Clignoduino/PROJET-ARDUINO-CLIGNODUINO/README.md

# PROJET-ARDUINO-CLIGNODUINO 

Projet

Présentation du projet Clignoduino, un projet de programmation électronique. Son objectif est d’accroître la sécurité des cyclistes avec un gant capteur de mouvements et des leds. Le tout est connecté via Bluetooth.
------------------------------------------------------------------------------------------------------------------------------------------------
Presentation of the Clignoduino project, an electronic programming project. Its goal is to increase the safety of cyclists with a motion sensor glove and Leds. Everything is connected via Bluetooth.

# >[Lien vidéo projet Clignoduino](https://youtu.be/3Vm6xSf7FyY)
