Clignoduino/PROJET-ARDUINO-CLIGNODUINO/Rapports séances/Rapports séances.md

# Rapports de séances
Ce dossier comporte nos rapports de séances respectifs présentant le travail réalisé en cours.

This file contains our respective session reports outlining the work done in class.
