Clignoduino/PROJET-ARDUINO-CLIGNODUINO/cahierdescharges.pdf

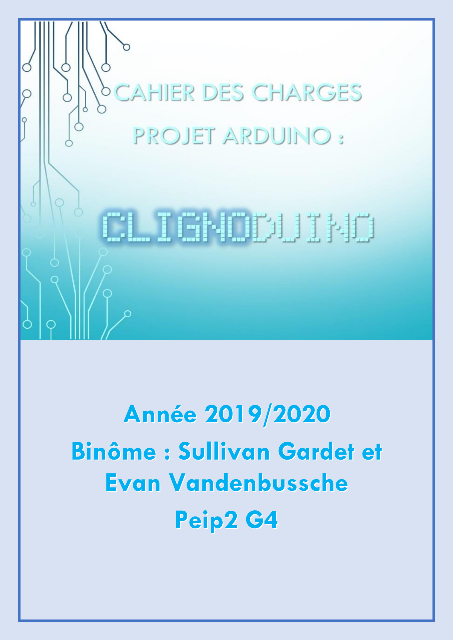
[picture p41: page 1]

Année 2019/2020
Binôme : Sullivan Gardet et Evan Vandenbussche
Peip2 G4

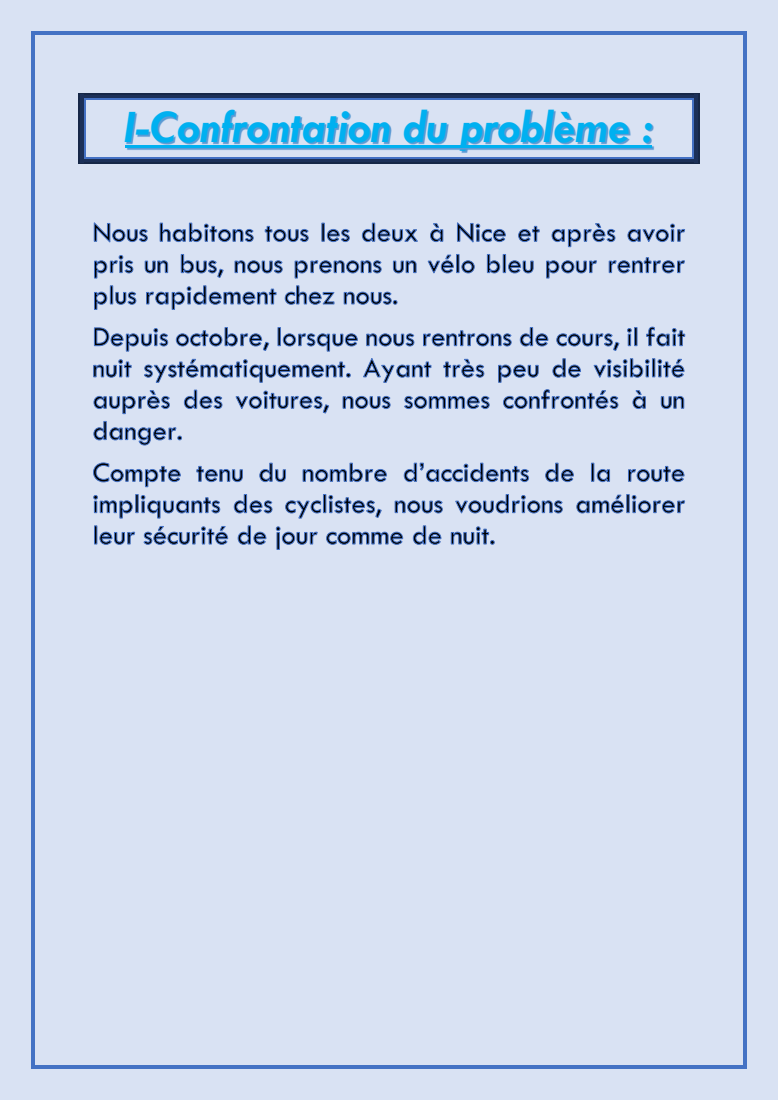
[picture p42: page 2]

I-Confrontation du problème :

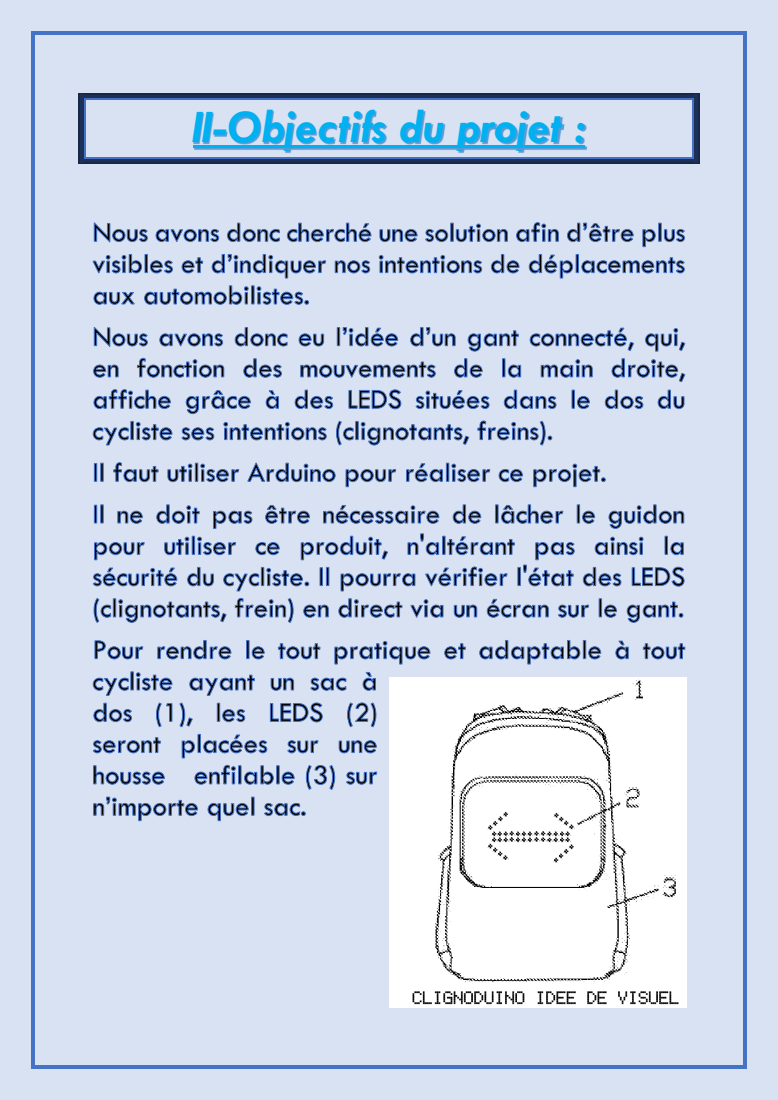
[picture p43: page 3]

II-Objectifs du projet :

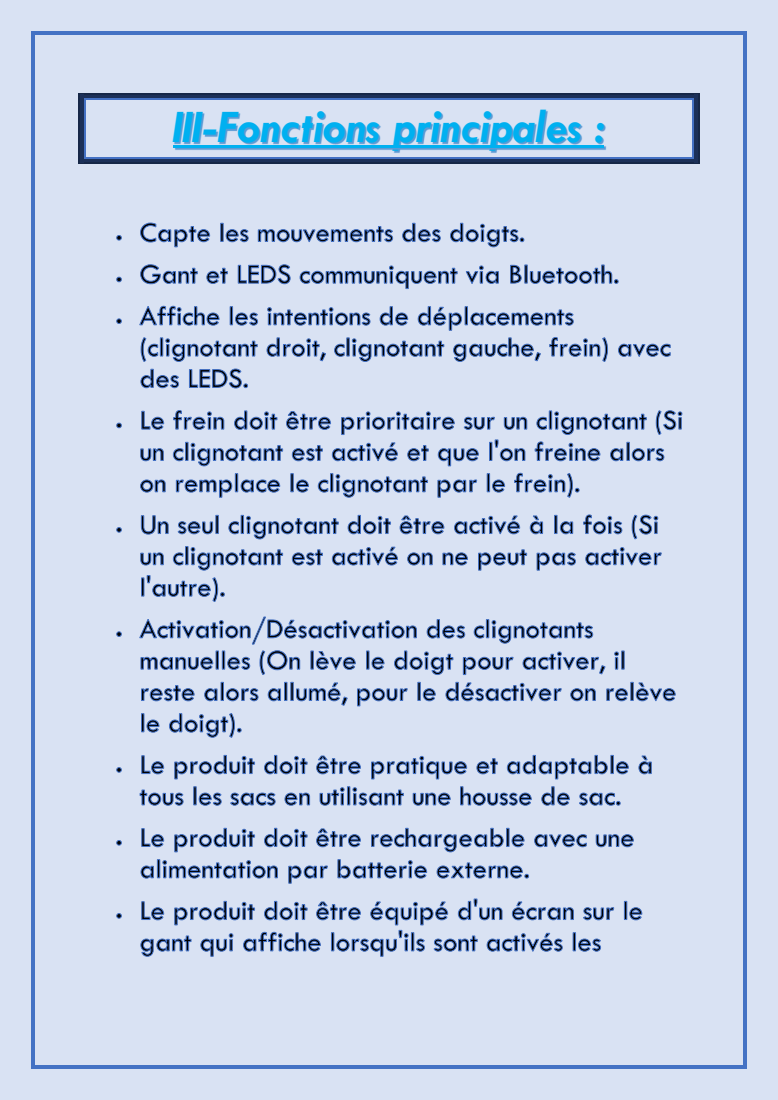
[picture p44: page 4]

III-Fonctions principales :

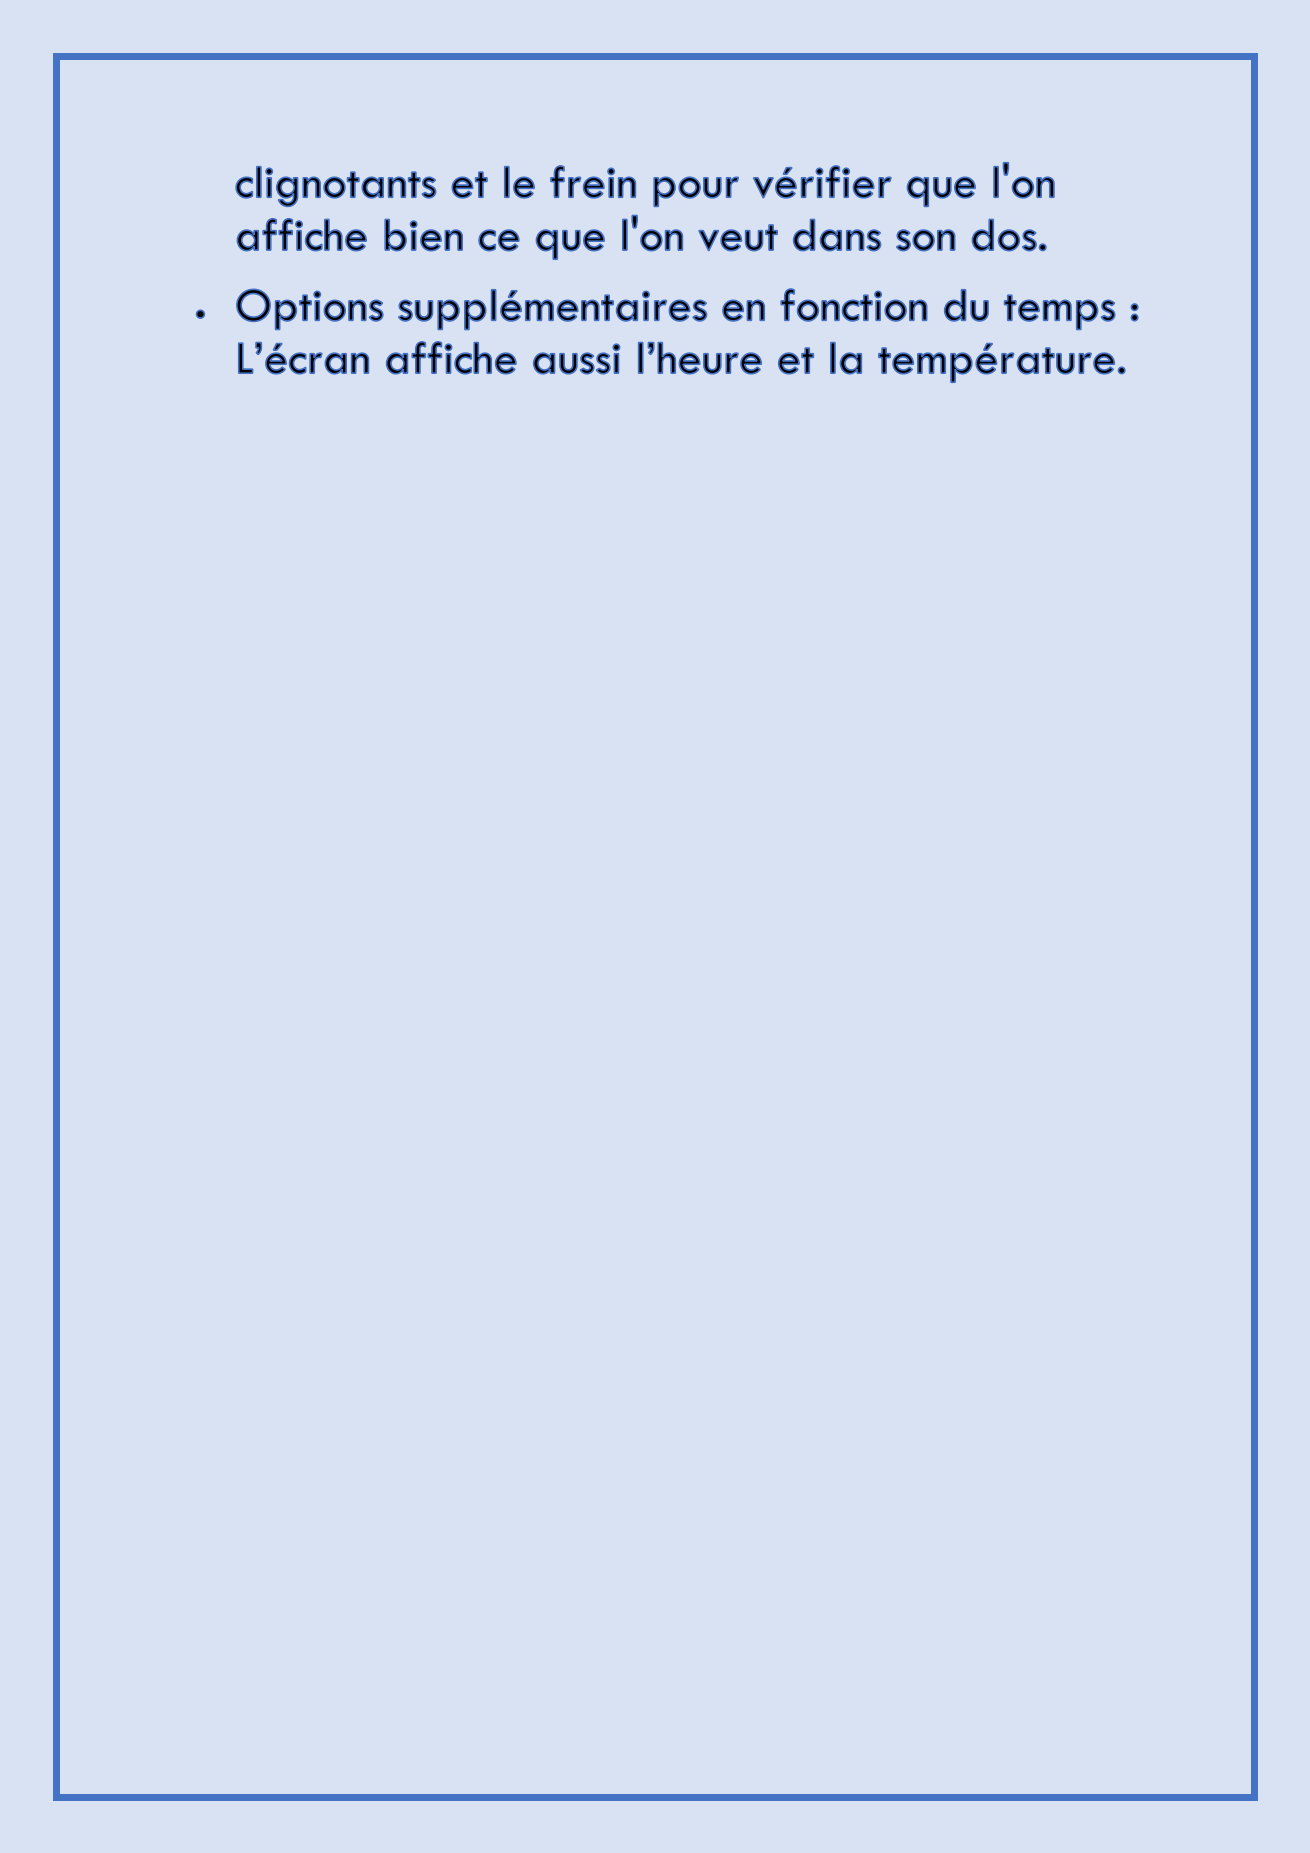
[picture p45: page 5]

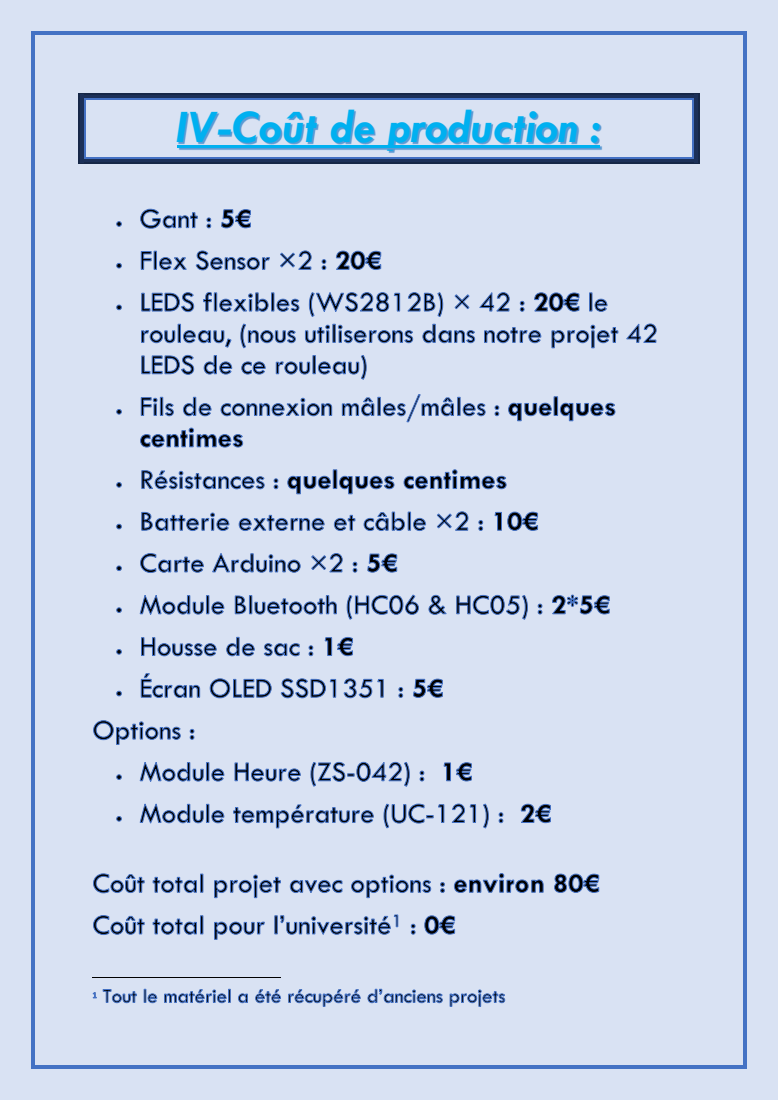
[picture p46: page 6]

IV-Coût de production :

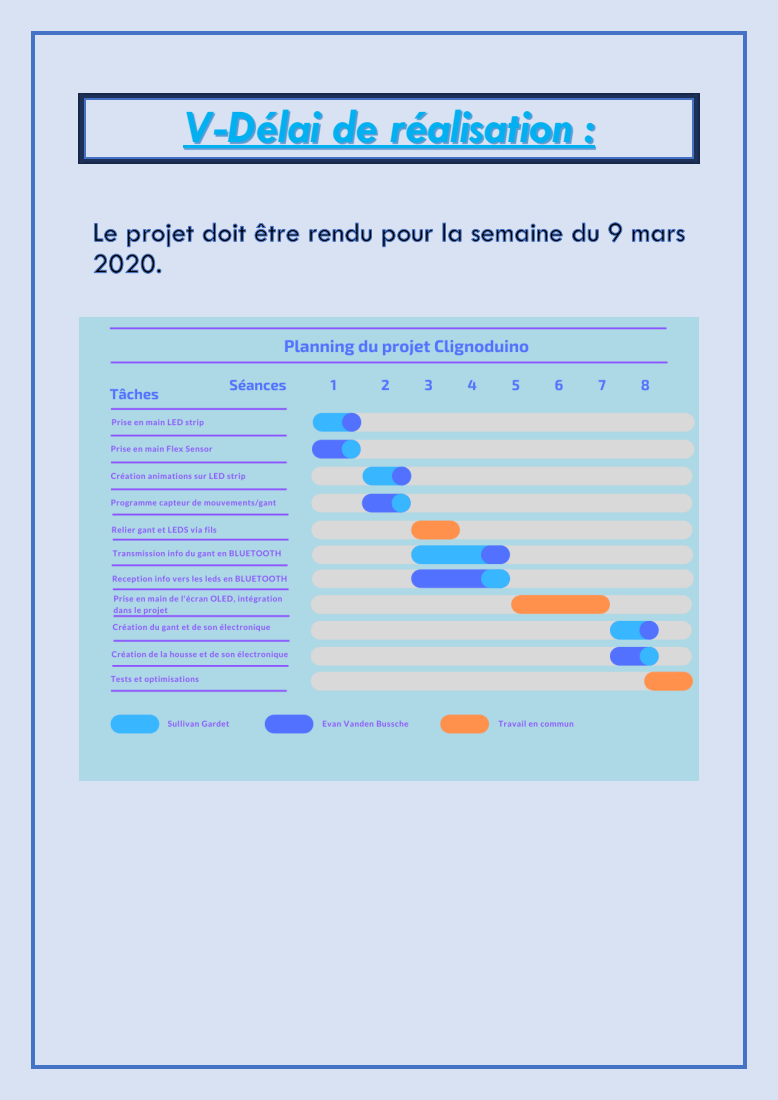
[picture p47: page 7]

V-Délai de réalisation :
