Clignoduino/PROJET-ARDUINO-CLIGNODUINO/Rapports séances/Séance 5/affichageimageecran.ino

#include <Wire.h>
#include <Adafruit_GFX.h>
#include <Adafruit_SH1106.h>

/* Puisque la bibliothèque est basée sur celle du SSD1306, le constructeur
prévoit qu'on passe le numéro de la broche RESET en argument. Mais le SH1106
n'a pas de broche RESET, alors on écrit n'importe quel entier (de préférence,
le numéro d'une broche de l'Arduino que vous n'utilisez pas). */

Adafruit_SH1106 display(23); 

const unsigned char flechedroite [] PROGMEM = {
0x00, 0x00, 0x00, 0x00, 0x00, 0x00, 0x00, 0x00, 0x00, 0x00, 0x00, 0x00, 0x00, 0x00, 0x00, 0x00, 
0x00, 0x00, 0x00, 0x00, 0x00, 0x00, 0x00, 0x00, 0x00, 0x00, 0x00, 0x00, 0x00, 0x00, 0x00, 0x00, 
0x00, 0x00, 0x00, 0x00, 0x00, 0x00, 0x00, 0x00, 0x00, 0x00, 0x00, 0x00, 0x00, 0x00, 0x00, 0x00, 
0x00, 0x00, 0x00, 0x00, 0x00, 0x00, 0x00, 0x00, 0x00, 0x00, 0x00, 0x00, 0x00, 0x00, 0x00, 0x00, 
0x00, 0x00, 0x00, 0x00, 0x00, 0x00, 0x00, 0x00, 0x00, 0x00, 0x00, 0x00, 0x00, 0x00, 0x00, 0x00, 
0x00, 0x00, 0x00, 0x00, 0x00, 0x00, 0x00, 0x00, 0x00, 0x00, 0x00, 0x00, 0x00, 0x00, 0x00, 0x00, 
0x00, 0x00, 0x00, 0x00, 0x00, 0x00, 0x00, 0x00, 0x00, 0x00, 0x00, 0x00, 0x00, 0x00, 0x00, 0x00, 
0x00, 0x00, 0x00, 0x00, 0x00, 0x03, 0xff, 0xff, 0xff, 0x00, 0x01, 0xff, 0xff, 0xff, 0x80, 0x00, 
0x1f, 0xff, 0xff, 0xfc, 0x00, 0x01, 0xff, 0xff, 0xff, 0x80, 0x00, 0xff, 0xff, 0xff, 0x80, 0x00, 
0x0f, 0xff, 0xff, 0xfc, 0x00, 0x01, 0xff, 0xff, 0xff, 0x80, 0x00, 0xff, 0xff, 0xff, 0xc0, 0x00, 
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
  
  display.display();
  delay(1000);
  display.clearDisplay();
  
  display.fillRect(0,0,128,64,WHITE);  // fond blanc derrière l'image bitmap
  display.drawBitmap(0, 0,frein, 128,  64, BLACK);
  
  display.display();
  delay(1000);
  display.clearDisplay();

}
