Clignoduino/PROJET-ARDUINO-CLIGNODUINO/Programmes/Gant/ecran.h

#include <Wire.h>
#include <Adafruit_GFX.h>
#include <Adafruit_SH1106.h>
/* Puisque la bibliothèque est basée sur celle du SSD1306, le constructeur
prévoit qu'on passe le numéro de la broche RESET en argument. Mais le SH1106
n'a pas de broche RESET, alors on écrit n'importe quel entier (de préférence,
le numéro d'une broche de l'Arduino que l'on utilise pas). */
Adafruit_SH1106 display(23); 

//Image fleche droite
const unsigned char flechedroite [] PROGMEM = {0x00, 0x00, 0x00, 0x00, 0x00, 0x00, 0x00, 0x00, 0x00, 0x00, 0x00, 0x00, 0x00, 0x00, 0x00, 0x00, 0x00, 0x00, 0x00, 0x00, 0x00, 0x00, 0x00, 0x00, 0x00, 0x00, 0x00, 0x00, 0x00, 0x00, 0x00, 0x00, 0x00, 0x00, 0x00, 0x00, 0x00, 0x00, 0x00, 0x00, 0x00, 0x00, 0x00, 0x00, 0x00, 0x00, 0x00, 0x00, 0x00, 0x00, 0x00, 0x00, 0x00, 0x00, 0x00, 0x00, 0x00, 0x00, 0x00, 0x00, 0x00, 0x00, 0x00, 0x00, 0x00, 0x00, 0x00, 0x00, 0x00, 0x00, 0x00, 0x00, 0x00, 0x00, 0x00, 0x00, 0x00, 0x00, 0x00, 0x00, 0x00, 0x00, 0x00, 0x00, 0x00, 0x00, 0x00, 0x00, 0x00, 0x00, 0x00, 0x00, 0x00, 0x00, 0x00, 0x00, 0x00, 0x00, 0x00, 0x00, 0x00, 0x00, 0x00, 0x00, 0x00, 0x00, 0x00, 0x00, 0x00, 0x00, 0x00, 0x00, 0x00, 0x00, 0x00, 0x00, 0x00, 0x03, 0xff, 0xff, 0xff, 0x00, 0x01, 0xff, 0xff, 0xff, 0x80, 0x00, 0x1f, 0xff, 0xff, 0xfc, 0x00, 0x01, 0xff, 0xff, 0xff, 0x80, 0x00, 0xff, 0xff, 0xff, 0x80, 0x00, 0x0f, 0xff, 0xff, 0xfc, 0x00, 0x01, 0xff, 0xff, 0xff, 0x80, 0x00, 0xff, 0xff, 0xff, 0xc0, 0x00, 0x0f, 0xff, 0xff, 0xfe, 0x00, 0x00, 0xff, 0xff, 0xff, 0xc0, 0x00, 0x7f, 0xff, 0xff, 0xc0, 0x00, 0x07, 0xff, 0xff, 0xff, 0x00, 0x00, 0xff, 0xff, 0xff, 0xc0, 0x00, 0x7f, 0xff, 0xff, 0xe0, 0x00, 0x03, 0xff, 0xff, 0xff, 0x00, 0x00, 0x7f, 0xff, 0xff, 0xe0, 0x00, 0x3f, 0xff, 0xff, 0xe0, 0x00, 0x03, 0xff, 0xff, 0xff, 0x80, 0x00, 0x3f, 0xff, 0xff, 0xf0, 0x00, 0x1f, 0xff, 0xff, 0xf0, 0x00, 0x01, 0xff, 0xff, 0xff, 0x80, 0x00, 0x3f, 0xff, 0xff, 0xf0, 0x00, 0x1f, 0xff, 0xff, 0xf0, 0x00, 0x01, 0xff, 0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
x00, 0x00, 0x00, 0x00, 0x00, 0x00, 0x00, 0x00, 0x00, 0x00, 0x00, 0x00, 0x00, 0x00, 0x00, 0x00, 0x00, 0x00, 0x00, 0x00, 0x00, 0x00, 0x00, 0x00, 0x00, 0x00, 0x00, 0x00, 0x00, 0x00, 0x00, 0x00};

//Image fleche gauche
const unsigned char flechegauche [] PROGMEM = {0x00, 0x00, 0x00, 0x00, 0x00, 0x00, 0x00, 0x00, 0x00, 0x00, 0x00, 0x00, 0x00, 0x00, 0x00, 0x00, 0x00, 0x00, 0x00, 0x00, 0x00, 0x00, 0x00, 0x00, 0x00, 0x00, 0x00, 0x00, 0x00, 0x00, 0x00, 0x00, 0x00, 0x00, 0x00, 0x00, 0x00, 0x00, 0x00, 0x00, 0x00, 0x00, 0x00, 0x00, 0x00, 0x00, 0x00, 0x00, 0x00, 0x00, 0x00, 0x00, 0x00, 0x00, 0x00, 0x00, 0x00, 0x00, 0x00, 0x00, 0x00, 0x00, 0x00, 0x00, 0x00, 0x00, 0x00, 0x00, 0x00, 0x00, 0x00, 0x00, 0x00, 0x00, 0x00, 0x00, 0x00, 0x00, 0x00, 0x00, 0x00, 0x00, 0x00, 0x00, 0x00, 0x00, 0x00, 0x00, 0x00, 0x00, 0x00, 0x00, 0x00, 0x00, 0x00, 0x00, 0x00, 0x00, 0x00, 0x00, 0x00, 0x00, 0x00, 0x00, 0x00, 0x00, 0x00, 0x00, 0x00, 0x00, 0x00, 0x00, 0x00, 0x01, 0xff, 0xff, 0xff, 0x80, 0x00, 0xff, 0xff, 0xff, 0xc0, 0x00, 0x00, 0x00, 0x00, 0x00, 0x00, 0x01, 0xff, 0xff, 0xff, 0x00, 0x01, 0xff, 0xff, 0xff, 0x80, 0x00, 0x3f, 0xff, 0xff, 0xf8, 0x00, 0x03, 0xff, 0xff, 0xff, 0x00, 0x01, 0xff, 0xff, 0xff, 0x80, 0x00, 0x3f, 0xff, 0xff, 0xf0, 0x00, 0x03, 0xff, 0xff, 0xfe, 0x00, 0x03, 0xff, 0xff, 0xff, 0x00, 0x00, 0x7f, 0xff, 0xff, 0xf0, 0x00, 0x07, 0xff, 0xff, 0xfe, 0x00, 0x03, 0xff, 0xff, 0xff, 0x00, 0x00, 0xff, 0xff, 0xff, 0xe0, 0x00, 0x07, 0xff, 0xff, 0xfc, 0x00, 0x07, 0xff, 0xff, 0xfe, 0x00, 0x00, 0xff, 0xff, 0xff, 0xc0, 0x00, 0x0f, 0xff, 0xff, 0xf8, 0x00, 0x07, 0xff, 0xff, 0xfc, 0x00, 0x01, 0xff, 0xff, 0xff, 0xc0, 0x00, 0x0f, 0xff, 0xff, 0xf8, 0x00, 0x0f, 0xff, 0xff, 0xfc, 0x00, 0x01, 0xff, 0xff, 0xff, 0x80, 0x00, 0x1f, 0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
00, 0x00, 0x00, 0x00, 0x00, 0x00, 0x00, 0x00, 0x00, 0x00, 0x00, 0x00, 0x00, 0x00, 0x00, 0x00, 0x00, 0x00, 0x00, 0x00, 0x00, 0x00, 0x00, 0x00, 0x00, 0x00, 0x00, 0x00, 0x00, 0x00, 0x00, 0x00};

//Animation Sablier
const unsigned char PROGMEM frame0 [] = {0x00, 0x00, 0x00, 0x00, 0x00, 0x00, 0x00, 0x00, 0x00, 0xFF, 0xFF, 0xFF, 0xFF, 0xFF, 0xFF, 0x00, 0x01, 0xFF, 0xFF, 0xFF, 0xFF, 0xFF, 0xFF, 0x80, 0x00, 0xFF, 0xFF, 0xFF, 0xFF, 0xFF, 0xFF, 0x00, 0x01, 0xC0, 0x00, 0x00, 0x00, 0x00, 0x03, 0x80, 0x00, 0xC0, 0x00, 0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
const unsigned char PROGMEM frame3 [] = {0x00, 0x00, 0x00, 0x00, 0x00, 0x00, 0x00, 0x00, 0x00, 0xFF, 0xFF, 0xFF, 0xFF, 0xFF, 0xFF, 0x00, 0x01, 0xFF, 0xFF, 0xFF, 0xFF, 0xFF, 0xFF, 0x80, 0x00, 0xFF, 0xFF, 0xFF, 0xFF, 0xFF, 0xFF, 0x00, 0x01, 0xC0, 0x00, 0x00, 0x00, 0x00, 0x03, 0x80, 0x00, 0xC0, 0x00, 0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
const unsigned char PROGMEM frame5 [] = {0x00, 0x00, 0x00, 0x00, 0x00, 0x00, 0x00, 0x00, 0x00, 0x00, 0x00, 0x00, 0x00, 0x00, 0x00, 0x00, 0x00, 0x00, 0x00, 0x00, 0x00, 0x00, 0x00, 0x00, 0x00, 0x00, 0x00, 0x07, 0x00, 0x00, 0x00, 0x00, 0x00, 0x00, 0x00, 0x0F, 0x80, 0x00, 0x00, 0x00, 0x00, 0x00, 0x00, 0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
const unsigned char PROGMEM frame6 [] = {0x00, 0x00, 0x00, 0x00, 0x00, 0x00, 0x00, 0x00, 0x00, 0x00, 0x00, 0x00, 0x00, 0x00, 0x00, 0x00, 0x00, 0x00, 0x00, 0x00, 0x00, 0x00, 0x00, 0x00, 0x00, 0x00, 0x00, 0x00, 0x00, 0x00, 0x00, 0x00, 0x00, 0x00, 0x00, 0x00, 0x00, 0x00, 0x00, 0x00, 0x00, 0x00, 0x00, 0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
const unsigned char PROGMEM frame8 [] = {0x00, 0x00, 0x00, 0x00, 0x00, 0x00, 0x00, 0x00, 0x00, 0x00, 0x00, 0x00, 0x00, 0x0F, 0x80, 0x00, 0x00, 0x00, 0x00, 0x00, 0x05, 0xFF, 0xC0, 0x00, 0x00, 0x00, 0x00, 0x00, 0xBF, 0xFF, 0xC0, 0x00, 0x00, 0x00, 0x00, 0x1F, 0xFF, 0xE1, 0xC0, 0x00, 0x00, 0x00, 0x0F, 0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
const unsigned char PROGMEM frame10 [] = {0x00, 0x00, 0x00, 0x00, 0x00, 0x00, 0x00, 0x00, 0x00, 0x3F, 0xF5, 0x00, 0x00, 0x00, 0x00, 0x00, 0x00, 0x3F, 0xFF, 0xFF, 0xFF, 0x54, 0x00, 0x00, 0x00, 0x3F, 0xFF, 0xFF, 0xFF, 0xFF, 0xFF, 0x00, 0x00, 0x38, 0x00, 0x57, 0xFF, 0xFF, 0xFF, 0x80, 0x00, 0x30, 0x00, 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
const unsigned char PROGMEM frame13 [] = {0x00, 0x00, 0x00, 0x00, 0x00, 0x00, 0x00, 0x00, 0x00, 0xFF, 0xFF, 0xFF, 0xFF, 0xFF, 0xFF, 0x00, 0x01, 0xFF, 0xFF, 0xFF, 0xFF, 0xFF, 0xFF, 0x80, 0x00, 0xFF, 0xFF, 0xFF, 0xFF, 0xFF, 0xFF, 0x00, 0x01, 0xC0, 0x00, 0x00, 0x00, 0x00, 0x03, 0x80, 0x00, 0xC0, 0x00, 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
const unsigned char PROGMEM frame15 [] = {0x00, 0x00, 0x00, 0x00, 0x00, 0x00, 0x00, 0x00, 0x00, 0xFF, 0xFF, 0xFF, 0xFF, 0xFF, 0xFF, 0x00, 0x01, 0xFF, 0xFF, 0xFF, 0xFF, 0xFF, 0xFF, 0x80, 0x00, 0xFF, 0xFF, 0xFF, 0xFF, 0xFF, 0xFF, 0x00, 0x01, 0xC0, 0x00, 0x00, 0x00, 0x00, 0x03, 0x80, 0x00, 0xC0, 0x00, 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
const unsigned char PROGMEM frame17 [] = {0x00, 0x00, 0x00, 0x00, 0x00, 0x00, 0x00, 0x00, 0x00, 0xFF, 0xFF, 0xFF, 0xFF, 0xFF, 0xFF, 0x00, 0x01, 0xFF, 0xFF, 0xFF, 0xFF, 0xFF, 0xFF, 0x80, 0x00, 0xFF, 0xFF, 0xFF, 0xFF, 0xFF, 0xFF, 0x00, 0x01, 0xC0, 0x00, 0x00, 0x00, 0x00, 0x03, 0x80, 0x00, 0xC0, 0x00, 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
const unsigned char PROGMEM frame19 [] = {0x00, 0x00, 0x00, 0x00, 0x00, 0x00, 0x00, 0x00, 0x00, 0xFF, 0xFF, 0xFF, 0xFF, 0xFF, 0xFF, 0x00, 0x01, 0xFF, 0xFF, 0xFF, 0xFF, 0xFF, 0xFF, 0x80, 0x00, 0xFF, 0xFF, 0xFF, 0xFF, 0xFF, 0xFF, 0x00, 0x01, 0xC0, 0x00, 0x00, 0x00, 0x00, 0x03, 0x80, 0x00, 0xC0, 0x00, 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
const unsigned char PROGMEM frame21 [] = {0x00, 0x00, 0x00, 0x00, 0x00, 0x00, 0x00, 0x00, 0x00, 0xFF, 0xFF, 0xFF, 0xFF, 0xFF, 0xFF, 0x00, 0x01, 0xFF, 0xFF, 0xFF, 0xFF, 0xFF, 0xFF, 0x80, 0x00, 0xFF, 0xFF, 0xFF, 0xFF, 0xFF, 0xFF, 0x00, 0x01, 0xC0, 0x00, 0x00, 0x00, 0x00, 0x03, 0x80, 0x00, 0xC0, 0x00, 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
const unsigned char PROGMEM frame24 [] = {0x00, 0x00, 0x00, 0x00, 0x00, 0x00, 0x00, 0x00, 0x00, 0xFF, 0xFF, 0xFF, 0xFF, 0xFF, 0xFF, 0x00, 0x01, 0xFF, 0xFF, 0xFF, 0xFF, 0xFF, 0xFF, 0x80, 0x00, 0xFF, 0xFF, 0xFF, 0xFF, 0xFF, 0xFF, 0x00, 0x01, 0xC0, 0x00, 0x00, 0x00, 0x00, 0x03, 0x80, 0x00, 0xC0, 0x00, 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
const unsigned char PROGMEM frame27 [] = {0x00, 0x00, 0x00, 0x00, 0x00, 0x00, 0x00, 0x00, 0x00, 0xFF, 0xFF, 0xFF, 0xFF, 0xFF, 0xFF, 0x00, 0x01, 0xFF, 0xFF, 0xFF, 0xFF, 0xFF, 0xFF, 0x80, 0x00, 0xFF, 0xFF, 0xFF, 0xFF, 0xFF, 0xFF, 0x00, 0x01, 0xC0, 0x00, 0x00, 0x00, 0x00, 0x03, 0x80, 0x00, 0xC0, 0x00, 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

int xx = -5; //position du sablier en x
int yy = 0; //position du sablier en y

int d=250;

//Image fleche droite
void imagedroite(){
  display.fillRect(0,0,128,64,WHITE);  // fond blanc derrière l'image bitmap
  display.drawBitmap(0, 0, flechedroite, 128,  64, BLACK);  // on affiche l'image stockée dans la constante myBitmap définie au début de ce fichier.
  display.display();
  delay(500);
}

//Image fleche gauche
void imagegauche(){
  display.fillRect(0,0,128,64,WHITE);  // fond blanc derrière l'image bitmap
  display.drawBitmap(0, 0, flechegauche, 128,  64, BLACK);  // on affiche l'image stockée dans la constante myBitmap définie au début de ce fichier.
  display.display();
  delay(500);
}

//Affiche "freinage"
void freinn(){
  display.setTextSize(2);
  display.setTextColor(WHITE);
  display.setCursor(18,30);
  display.println("FREINAGE");
  display.display();
  delay(500);
  display.clearDisplay();
}

//Animation Sablier
void sablier(){
  display.clearDisplay();
display.drawBitmap(xx, yy,frame0,64,64, 1);
display.display();

display.clearDisplay();
display.drawBitmap(xx, yy,frame3,64,64, 1);
display.display();

display.clearDisplay();
display.drawBitmap(xx, yy,frame5,64,64, 1);
display.display();

display.clearDisplay();
display.drawBitmap(xx, yy,frame6,64,64, 1);
display.display();


display.clearDisplay();
display.drawBitmap(xx, yy,frame8,64,64, 1);
display.display();

display.clearDisplay();
display.drawBitmap(xx, yy,frame10,64,64, 1);
display.display();


display.clearDisplay();
display.drawBitmap(xx, yy,frame13,64,64, 1);
display.display();


display.clearDisplay();
display.drawBitmap(xx, yy,frame15,64,64, 1);
display.display();


display.clearDisplay();
display.drawBitmap(xx, yy,frame17,64,64, 1);
display.display();

display.clearDisplay();
display.drawBitmap(xx, yy,frame19,64,64, 1);
display.display();

display.clearDisplay();
display.drawBitmap(xx, yy,frame21,64,64, 1);
display.display();

display.clearDisplay();
display.drawBitmap(xx, yy,frame24,64,64, 1);
display.display();

display.clearDisplay();
display.drawBitmap(xx, yy,frame27,64,64, 1);
display.display();

  display.setTextSize(2);
  display.setTextColor(WHITE);
  display.setCursor(60,5);
  display.println("Ne");
  display.setCursor(60,25);
  display.println("Pas");
  display.setCursor(56,45);
  display.println("bouger");
  display.display();
  delay(1000);
}

//Affiche "ne pas bouger"
void NePasBouger(){
  display.setTextSize(2);
  display.setTextColor(WHITE);
  display.setCursor(60,5);
  display.println("Ne");
  display.setCursor(60,25);
  display.println("Pas");
  display.setCursor(56,45);
  display.println("bouger");
  display.display();
  delay(1000);
}

//Affiche un rectangle qui clignotte autour de "Cligno"
void RectangleClignoNoir(){
    display.drawRect(13,8,100,25,BLACK);
  display.display();
  display.drawRect(13,8,101,26,BLACK);
  display.display();
  display.drawRect(13,8,102,27,BLACK);
  display.display();
}

//Affiche un rectangle qui clignotte autour de "Cligno"
void RectangleClignoBlanc(){
    display.drawRect(13,8,100,25,WHITE);
  display.display();
  display.drawRect(13,8,101,26,WHITE);
  display.display();
  display.drawRect(13,8,102,27,WHITE);
  display.display();
}

//Affiche Clignoduino et nos prénoms
void Intro(){
  display.fillRoundRect(0,0,128,65,25,WHITE);
  display.display();
  display.setTextSize(3);
  display.setTextColor(BLACK);
  display.setCursor(15,10);
  display.println("C");
  display.display();
  delay(d);
  display.setCursor(33,10);
  display.println("L");
  display.display();
  delay(d);
  display.setCursor(48,10);
  display.println("I");
  display.display();
  delay(d);
  display.setCursor(61,10);
  display.println("G");
  display.display();
  delay(d);
  display.setCursor(80,10);
  display.println("N");
  display.display();
  delay(d);
  display.setCursor(98,10);
  display.println("O");
  display.display();
  delay(d);
  RectangleClignoNoir();
  delay(100);
  RectangleClignoBlanc();
  delay(100);
    RectangleClignoNoir();
  delay(100);
  RectangleClignoBlanc();
  delay(100);
      RectangleClignoNoir();
  delay(100);
  display.setCursor(20,38);
  display.println("DUINO");
  display.display();
  delay(1000);
  display.clearDisplay();
  display.setTextSize(2);
  display.setTextColor(BLACK);
  display.fillRoundRect(0,0,128,65,25,WHITE);
  display.display();
  display.setCursor(7,8);
  display.println("Project by");
  display.display();
  display.setCursor(40,25);
  display.println("Evan");
  display.display();
  display.setCursor(15,45);
  display.println("Sullivan");
  display.display();
  delay(2000);
}

//Affiche "verifiez les cables"
void branchement(){
  display.setTextSize(2);
  display.setTextColor(BLACK);
  display.fillRoundRect(0,0,128,65,25,WHITE);
  display.display();
  display.setCursor(16,2);
  display.println("Verifiez");
  display.display();
  display.setCursor(40,25);
  display.println("Les");
  display.display();
  display.setCursor(30,45);
  display.println("Cables");
  display.display();

}
