Clignoduino/PROJET-ARDUINO-CLIGNODUINO/(commit log)

2019-11-27 Create Rapports de séances.md
2019-11-27 Update Rapports de séances.md
